Equilibris/bridge-scad/report/assets/bend-closer.jpg

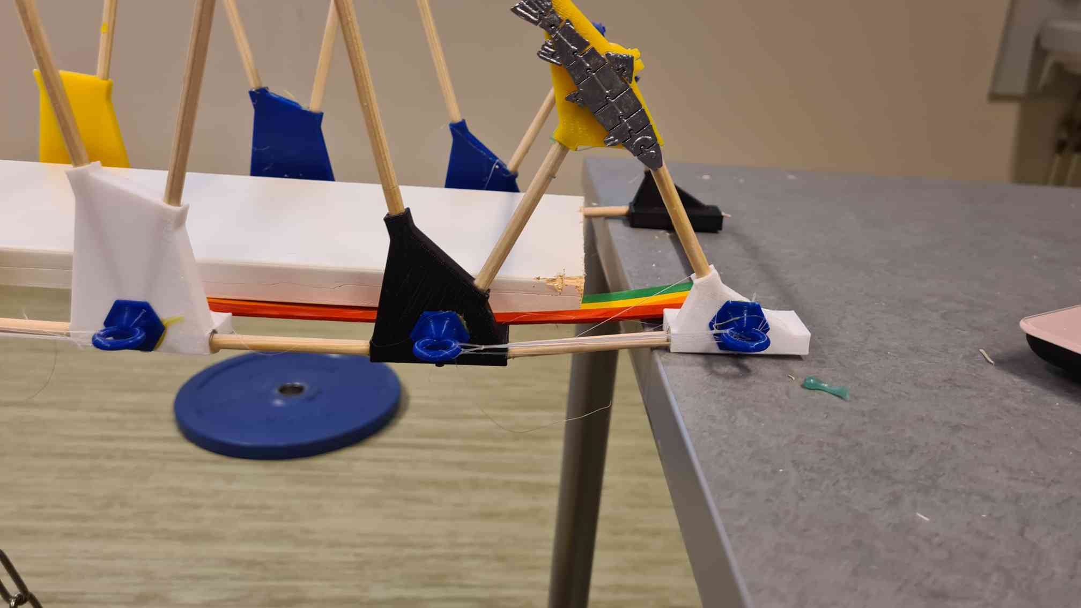
report/assets/bend-closer.jpg
