Equilibris/bridge-scad/report/assets/cube-b.jpg

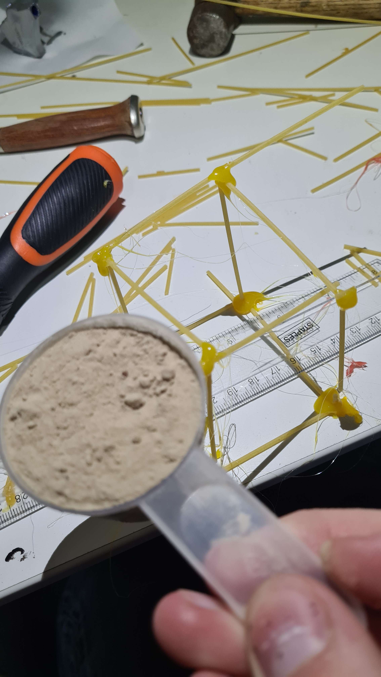
report/assets/cube-b.jpg
