Equilibris/bridge-scad/report/assets/front view.jpg

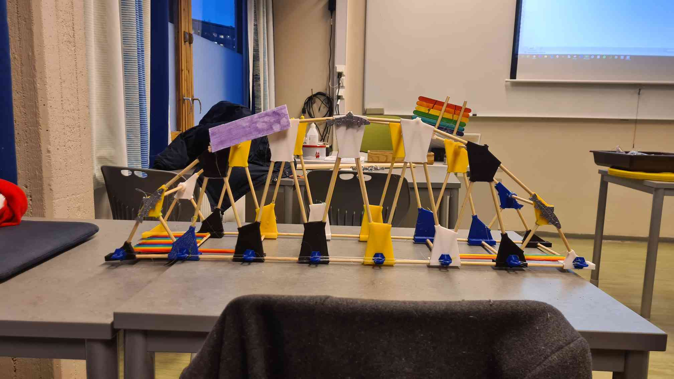
report/assets/front view.jpg
