Equilibris/bridge-scad/report/assets/jhu.png

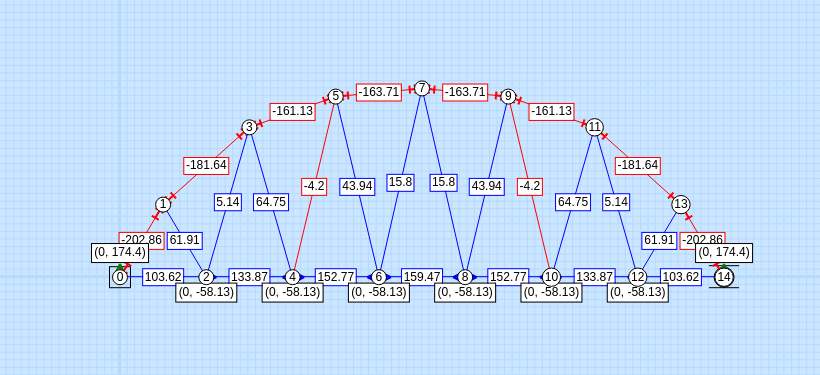
report/assets/jhu.png
