Equilibris/bridge-scad/report/assets/loadtest bend.jpg

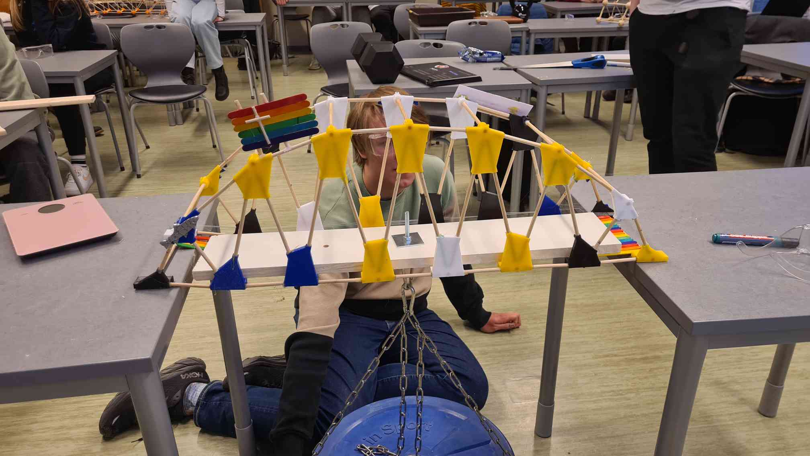
report/assets/loadtest bend.jpg
