Equilibris/bridge-scad/report/assets/side b.jpg

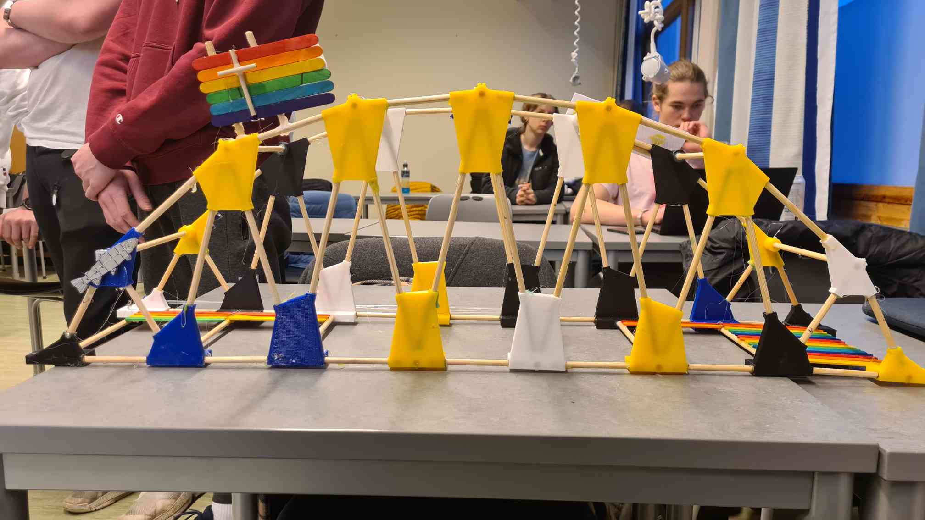
report/assets/side b.jpg
