Equilibris/bridge-scad/report/assets/task-3-far.jpg

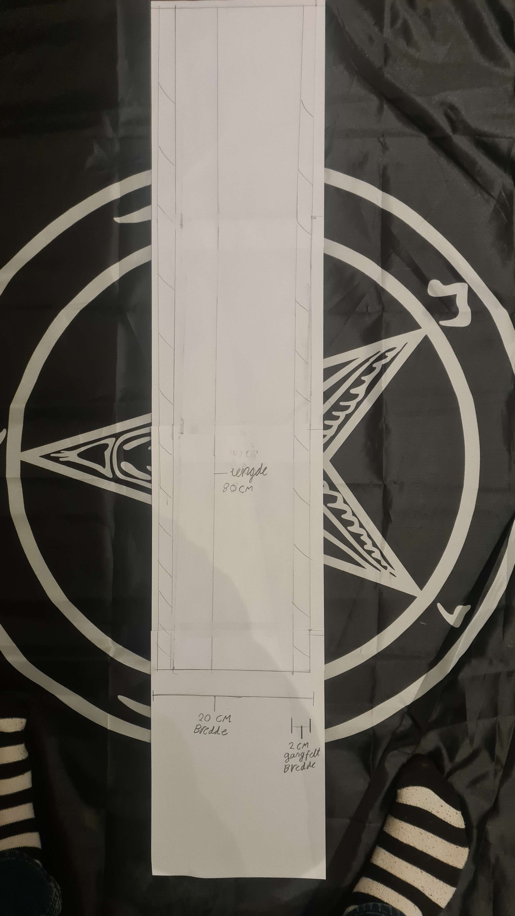
report/assets/task-3-far.jpg
