Equilibris/bridge-scad/report/assets/task-3-near.jpg

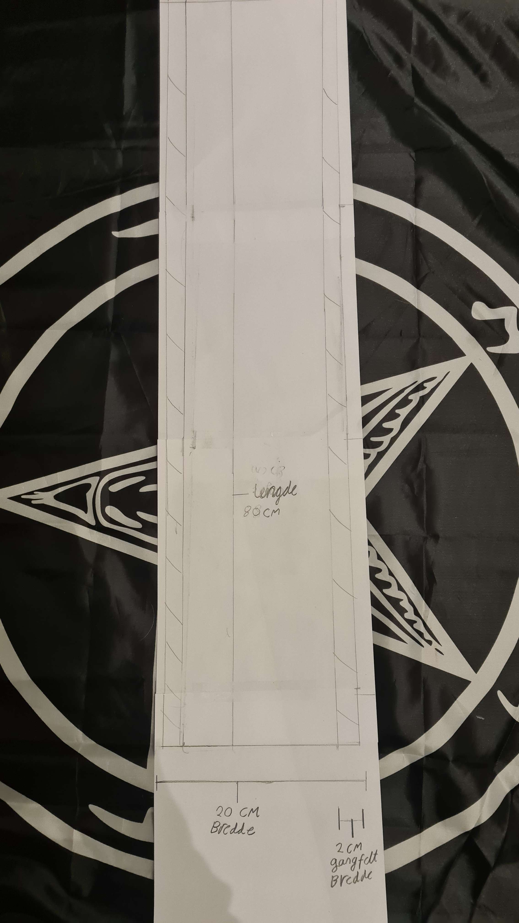
report/assets/task-3-near.jpg
