Equilibris/bridge-scad/report/assets/task-6-abc-formulas.png

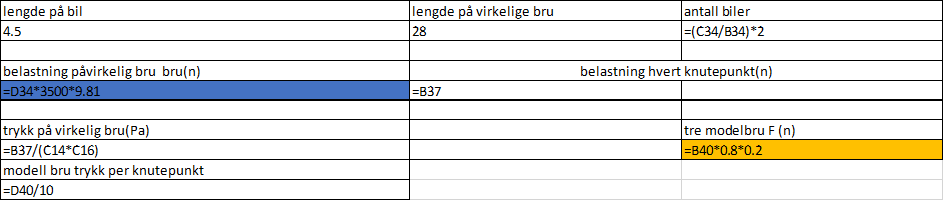
report/assets/task-6-abc-formulas.png
