Equilibris/bridge-scad/report/assets/task-6-abc.png

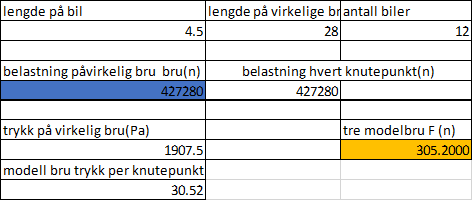
report/assets/task-6-abc.png
