Equilibris/bridge-scad/report/assets/task-6D-formulas.png

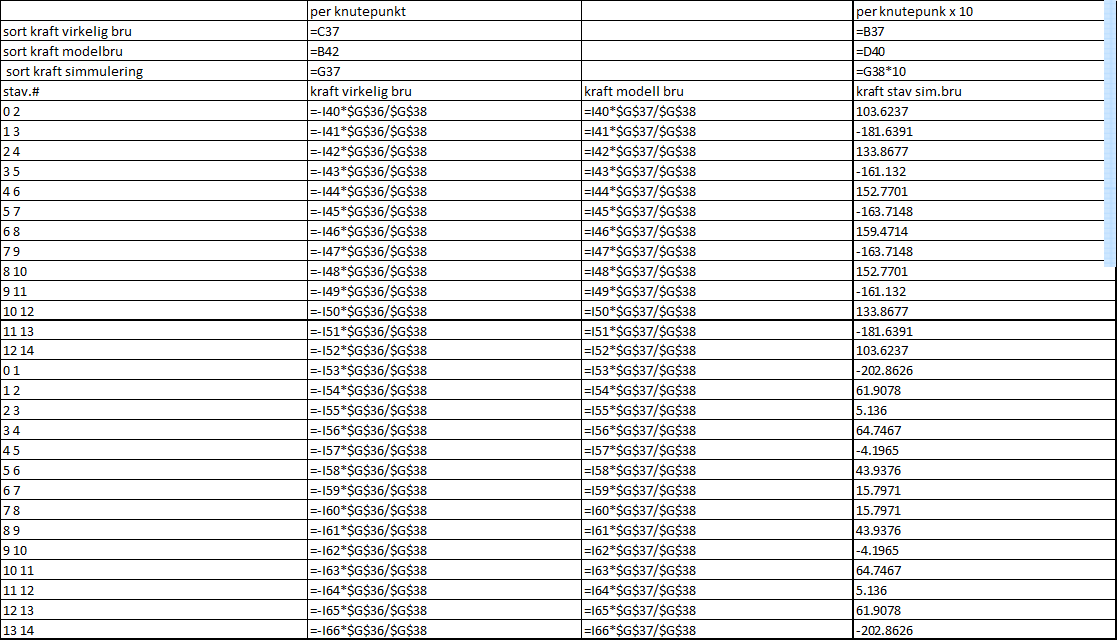
report/assets/task-6D-formulas.png
