Equilibris/bridge-scad/report/assets/task-6D.png

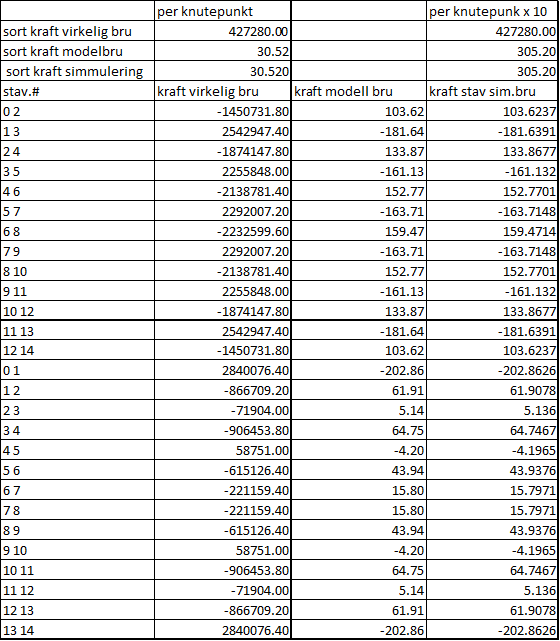
report/assets/task-6D.png
