Equilibris/bridge-scad/(commit log)

2022-11-25 LoL misc changes
    [bridge.scad]
2022-11-27 Num output previewing
    [bridge.scad]
2022-11-28 misc changes
    [bridge.scad]
2022-12-01 Change report and add bibtex
    [bridge.scad]
